ninthgiant/Burrow_Scale_Monitor/README.md

# Burrow_Scale_Monitor
Supplemental Information for Mauck, et al. 2025. Final versions of Arduino, Python, and 3D printing files for the Burrow Scale Monitoring system.
