ninthgiant/Burrow_Scale_Monitor/3D printing/ConnectorAssembly_WireClamp.3mf

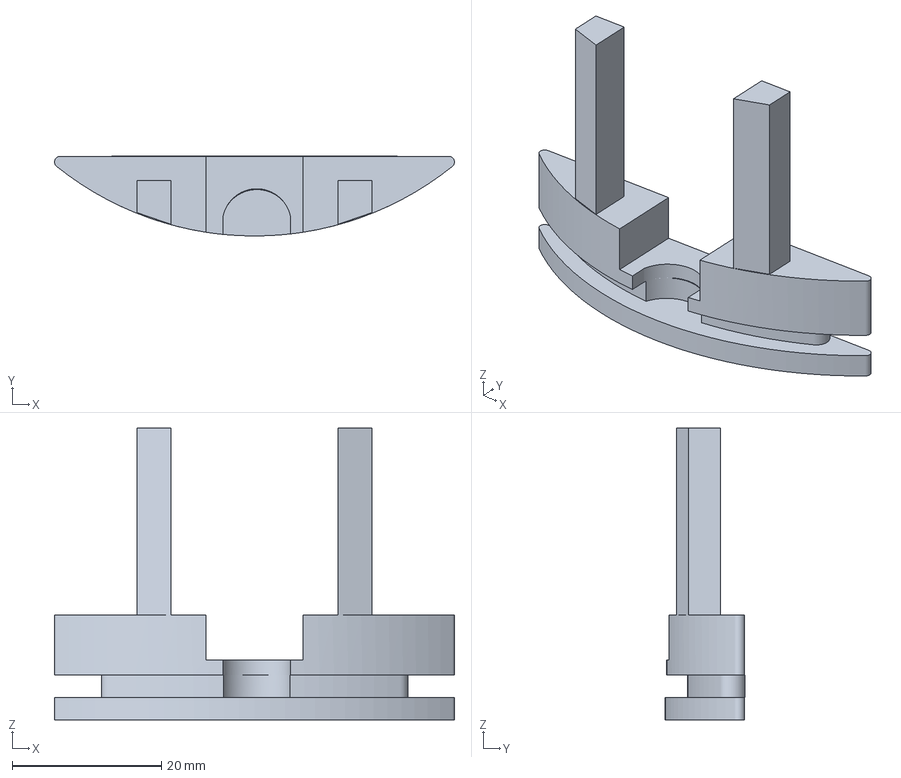
[picture p1: CAD file, 2025-09-29]
3D printing/ConnectorAssembly_WireClamp.3mf
53.5 x 10.7 x 39.0 mm
