ninthgiant/Burrow_Scale_Monitor/3D printing/ConnectorAssembly_Plug.3mf

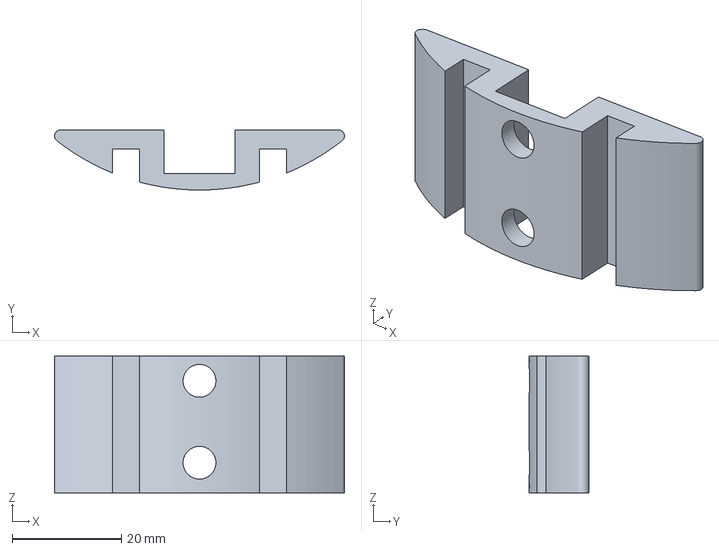
[picture p2: CAD file, 2025-09-29]
3D printing/ConnectorAssembly_Plug.3mf
53.1 x 11.0 x 25.0 mm
