ninthgiant/Burrow_Scale_Monitor/3D printing/Weight_Platform.3mf

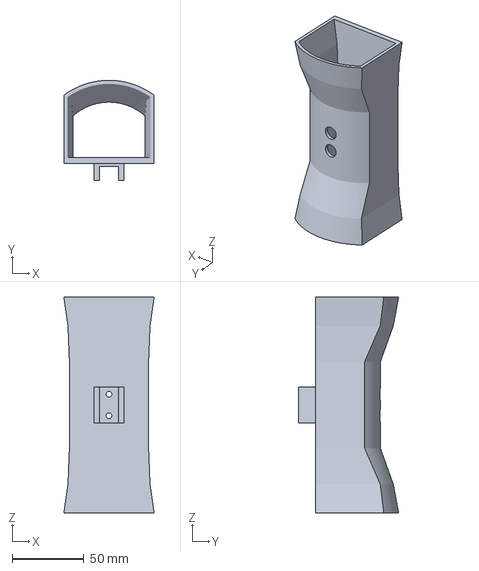
[picture p3: CAD file, 2025-09-29]
3D printing/Weight_Platform.3mf
62.7 x 69.7 x 150.0 mm
