ninthgiant/Burrow_Scale_Monitor/3D printing/SuperJig_001.3mf

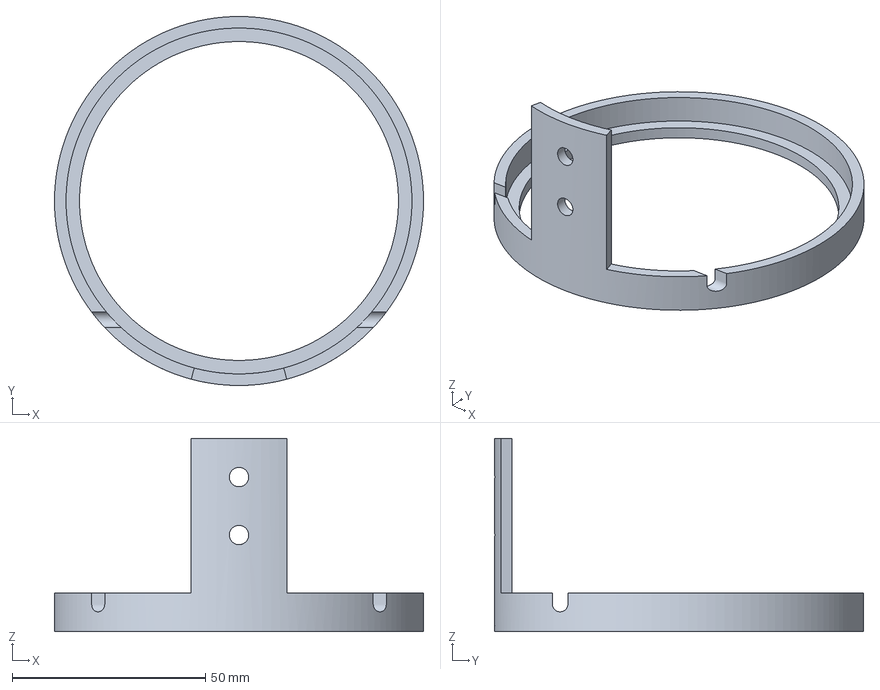
[picture p4: CAD file, 2025-09-29]
3D printing/SuperJig_001.3mf
95.6 x 95.6 x 50.0 mm
