ninthgiant/Burrow_Scale_Monitor/3D printing/Exit_Cap.3mf

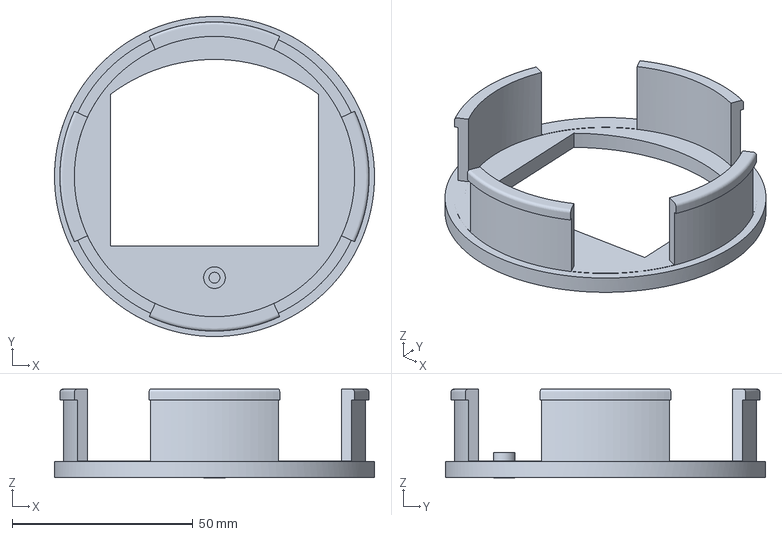
[picture p5: CAD file, 2025-09-29]
3D printing/Exit_Cap.3mf
88.6 x 88.6 x 24.6 mm
