ninthgiant/Burrow_Scale_Monitor/3D printing/Entrance_Cap.3mf

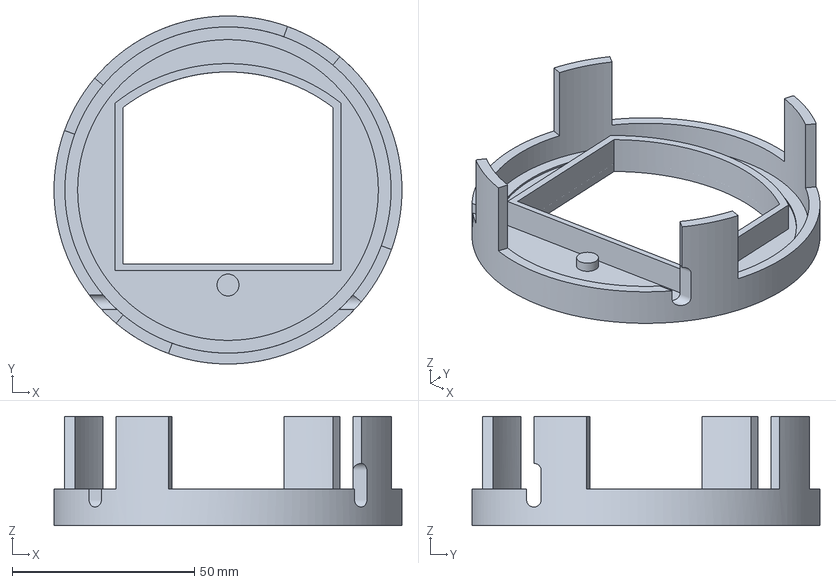
[picture p6: CAD file, 2025-09-29]
3D printing/Entrance_Cap.3mf
95.6 x 95.6 x 30.0 mm
