ninthgiant/Burrow_Scale_Monitor/Arduino Code/BSM_Fritzing.pdf

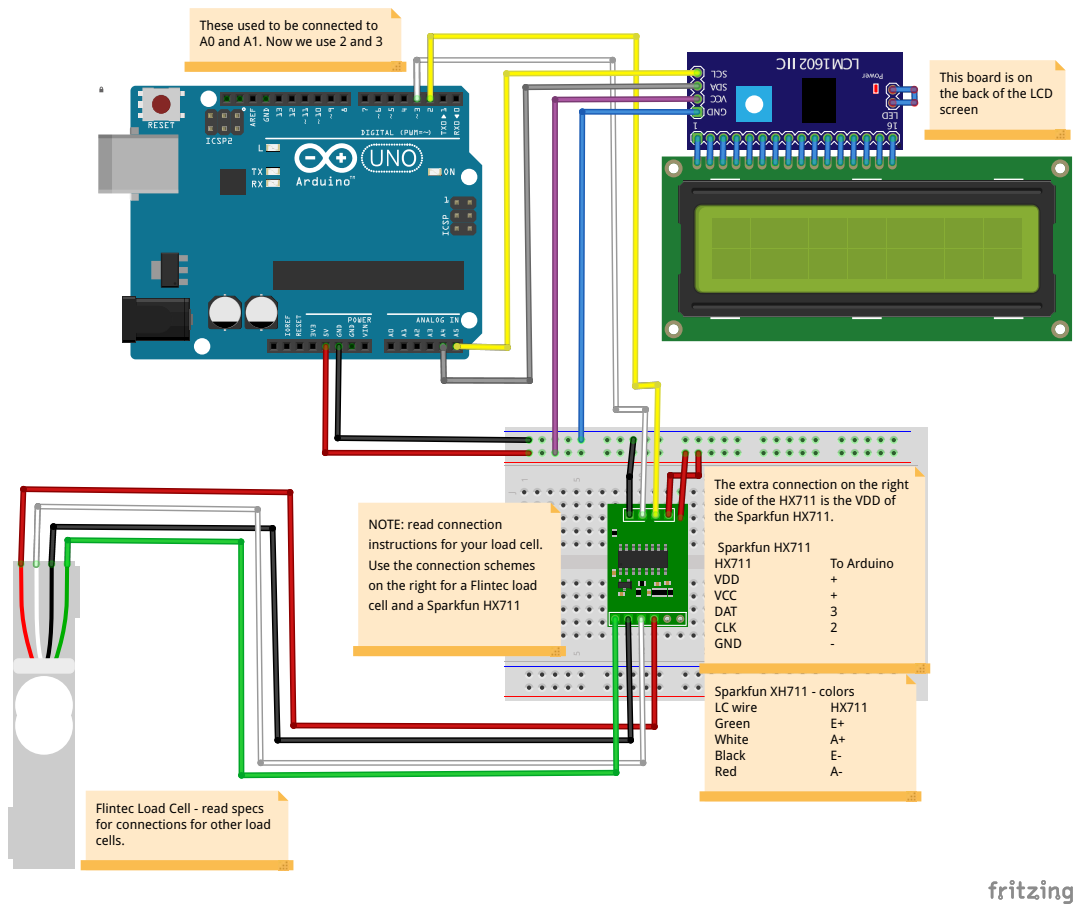
[picture p7: page 1]
Sparkfun XH711 - colors; LC wire; Green; White; Black; Red; Sparkfun HX711; To Arduino; VDD; VCC; DAT; CLK; GND

These used to be connected to
A0 and A1. Now we use 2 and 3

This board is on
the back of the LCD
screen

The extra connection on the right
side of the HX711 is the VDD of
the Sparkfun HX711.

NOTE: read connection
instructions for your load cell.
Use the connection schemes
on the right for a Flintec load
cell and a Sparkfun HX711

Flintec Load Cell - read specs
for connections for other load
cells.
