ninthgiant/Burrow_Scale_Monitor/Arduino Code/PRDC_AD7193/src/PRDC_AD7193.cpp

/**
 * PRDC_AD7193.cpp - Analog Devices AD7193 ADC Library
 * Author: Milos Petrasinovic <mpetrasinovic@pr-dc.com>
 * PR-DC, Republic of Serbia
 * info@pr-dc.com
 * 
 * --------------------
 * Copyright (C) 2021 PR-DC <info@pr-dc.com>
 *
 * This file is part of PRDC_AD7193.
 *
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
 */

#include "PRDC_AD7193.h"

// PRDC_AD7193()
// Object constructor
// --------------------
PRDC_AD7193::PRDC_AD7193() :
  _spiSettings(AD7193_DEFAULT_SPI_FREQUENCY, MSBFIRST, SPI_MODE3),
  _spi(&AD7193_DEFAULT_SPI), _CS(AD7193_DEFAULT_CS), _MISO(AD7193_DEFAULT_MISO) {
  //_spi(&AD7193_DEFAULT_SPI), _CS(PIN_SPI_SS), _MISO(PIN_SPI_MISO) {

}

// setSPI() function
// Set SPI object
// --------------------
void PRDC_AD7193::setSPI(SPIClass& spi) {
  #ifdef DEBUG_AD7193
    Serial.println(F("setSPI()"));
  #endif
  
  _spi = &spi;
}

// setSPIFrequency() function
// Set SPI frequency
// --------------------
void PRDC_AD7193::setSPIFrequency(uint32_t frequency) {
  #ifdef DEBUG_AD7193
    Serial.println(F("setSPIFrequency()"));
  #endif
  
  _spiSettings = SPISettings(frequency, MSBFIRST, SPI_MODE3);
}

// beginTransaction() function
// Begin SPI transaction 
// --------------------
inline void PRDC_AD7193::beginTransaction() {
  _spi->beginTransaction(_spiSettings);
  digitalWrite(_CS, LOW);
}

// endTransaction() function
// End SPI transaction 
// --------------------
inline void PRDC_AD7193::endTransaction() {
  digitalWrite(_CS, HIGH);
  _spi->endTransaction();
}

// getRegister() function
// Reads the value of a register
// --------------------
uint32_t PRDC_AD7193::getRegister(uint8_t registerAddress, uint8_t bytesNumber) {
  #ifdef DEBUG_AD7193
    Serial.println(F("getRegister()"));
    Serial.print(F("Register "));
    Serial.println(registerAddress);
  #endif
  
  uint32_t buffer = 0x0;
  _spi->transfer(AD7193_COMM_READ | AD7193_COMM_ADDR(registerAddress));
  for(uint8_t i = 0; i < bytesNumber; i++)  {
      buffer = (buffer << 8) + _spi->transfer(0);
  }
  
  #ifdef DEBUG_AD7193
    Serial.println(buffer);
  #endif
  return buffer; 
}

// getSingleRegister() function
// Reads the value of a single register
// --------------------
uint32_t PRDC_AD7193::getSingleRegister(uint8_t registerAddress, uint8_t bytesNumber) {
  #ifdef DEBUG_AD7193
    Serial.println(F("getSingleRegister()"));
  #endif
  
  this->beginTransaction();
  uint32_t regVal = this->getRegister(registerAddress, bytesNumber);
  this->endTransaction();
  return regVal;
}

// setRegister() function
// Set the value of a register
// --------------------
void PRDC_AD7193::setRegister(uint8_t registerAddress, uint32_t value, uint8_t bytesNumber) {
  #ifdef DEBUG_AD7193
    Serial.println(F("setRegister()"));
    Serial.print(F("Register "));
    Serial.print(registerAddress);
    Serial.print(F(" Value "));
    Serial.println(value);
  #endif
  
  uint8_t* dataPointer = (uint8_t*)&value;
  _spi->transfer(AD7193_COMM_WRITE | AD7193_COMM_ADDR(registerAddress));
  for(uint8_t i = 0; i < bytesNumber; i++)  {
    _spi->transfer(*(dataPointer + (bytesNumber-1) - i));
  }
}

// setSingleRegister() function
// Set the value of a single register
// --------------------
void PRDC_AD7193::setSingleRegister(uint8_t registerAddress, uint32_t value, uint8_t bytesNumber) {
  #ifdef DEBUG_AD7193
    Serial.println(F("setSingleRegister()"));
  #endif
  
  this->beginTransaction();
  this->setRegister(registerAddress, value, bytesNumber);
  this->endTransaction();
}

// begin() function
// Begin communication
// --------------------
bool PRDC_AD7193::begin() {
  #ifdef DEBUG_AD7193
    Serial.println(F("begin()"));
    Serial.println(F("PRDC_AD7193 constructor instantiated successfully"));
    Serial.print(F("CS "));
    Serial.println(_CS);
    Serial.print(F("MISO "));
    Serial.println(_MISO);
  #endif
  
  _spi->begin();
  this->pinInit();
  this->reset();
  if(this->checkID()) {
    return true;
  }
  return false;
}

bool PRDC_AD7193::begin(uint8_t CS, uint8_t MISO) {
  _CS = CS;
  _MISO = MISO;
  return this->begin();
}

// end() function
// End communication
// --------------------
void PRDC_AD7193::end() {
  #ifdef DEBUG_AD7193
    Serial.println(F("end()"));
  #endif
  
  _spi->end();
}

// pinInit() function
// Pin initialization
// --------------------
void PRDC_AD7193::pinInit() {
  #ifdef DEBUG_AD7193
    Serial.println(F("pinInit()"));
  #endif

  pinMode(_CS, OUTPUT);
  digitalWrite(_CS, HIGH);
}

// reset() function
// Reset ADC
// --------------------
void PRDC_AD7193::reset() {
  #ifdef DEBUG_AD7193
    Serial.println(F("reset()"));
  #endif

  this->beginTransaction();
  _spi->transfer(0xFF);
  _spi->transfer(0xFF);
  _spi->transfer(0xFF);
  _spi->transfer(0xFF);
  _spi->transfer(0xFF);
  _spi->transfer(0xFF);
  this->endTransaction();
}

// setClockMode() function
// Set clock mode (internal or external)
// --------------------
void PRDC_AD7193::setClockMode(uint8_t clock_mode) {
  #ifdef DEBUG_AD7193
    Serial.println(F("setClockMode()"));
  #endif
  
  _clock_mode = clock_mode;
}

// setRate() function
// Set output data rate
// --------------------
void PRDC_AD7193::setRate(uint32_t rate) {
  #ifdef DEBUG_AD7193
    Serial.println(F("setRate()"));
  #endif
  
  _rate = rate;
}

// setFilter() function
// Set filter type (Sinc3 or Sinc4)
// --------------------
void PRDC_AD7193::setFilter(uint32_t filter) {
  #ifdef DEBUG_AD7193
    Serial.println(F("setFilter()"));
  #endif
  
  _filter = filter;
  
  updateConf();
}

// enableNotchFilter() function
// Turn on or off notch filter;
// --------------------
void PRDC_AD7193::enableNotchFilter(bool notch_state) {
  #ifdef DEBUG_AD7193
    Serial.println(F("enableNotchFilter()"));
  #endif
  
  if(notch_state) {
    _notch_filter = AD7193_MODE_REJ60;
  } else {
    _notch_filter = AD7193_MODE_NO_REJ60;
  }
  
  updateConf();
}

// enableChop() function
// Turn on or off chop;
// --------------------
void PRDC_AD7193::enableChop(bool chop_state) {
  #ifdef DEBUG_AD7193
    Serial.println(F("enableChop()"));
  #endif
  
  if(chop_state) {
    _chop = AD7193_CONF_CHOP;
  } else {
    _chop = AD7193_CONF_NO_CHOP;
  }
  
  updateConf();
}

// enableBuffer() function
// Turn on or off buffer;
// --------------------
void PRDC_AD7193::enableBuffer(bool buffer_state) {
  #ifdef DEBUG_AD7193
    Serial.println(F("enableBuffer()"));
  #endif
  
  if(buffer_state) {
    _buf = AD7193_CONF_BUF;
  } else {
    _buf = AD7193_CONF_NO_BUF;
  }
  
  updateConf();
}

// updateConf() function
// Update conf register
// --------------------
void PRDC_AD7193::updateConf(void) {
  #ifdef DEBUG_AD7193
    Serial.println(F("updateConf()"));
  #endif
  
  uint32_t command = AD7193_CONF_CHAN(1 << _channel) | 
                    (_polarity * AD7193_CONF_UNIPOLAR) |
                    _gain |
                    _filter |
                    _notch_filter | 
                    _chop |
                    _buf |
                    _burnout; 
                        
  this->beginTransaction();
  this->setRegister(AD7193_REG_CONF, command, 3);
  this->endTransaction();
}

// checkID() function
// Check ADC ID register
// --------------------
bool PRDC_AD7193::checkID() {
  #ifdef DEBUG_AD7193
    Serial.println(F("checkID()"));
  #endif
  
  uint8_t regVal = getSingleRegister(AD7193_REG_ID, 1);
  #ifdef DEBUG_AD7193
    Serial.print(F("ID = "));
    Serial.println(regVal & AD7193_ID_MASK);
  #endif
  return (regVal & AD7193_ID_MASK) == ID_AD7193;
}

// waitReady() function
// Waits for MISO pin to go low
// --------------------
void PRDC_AD7193::waitReady() {
  #ifdef DEBUG_AD7193
    Serial.println(F("waitReady()"));
  #endif
  while(digitalRead(_MISO)) {}
}

// setPower() function
// Set device to idle or power-down
// mode = 
//  0 - power-down
//  1 - idle
// --------------------
void PRDC_AD7193::setPower(uint8_t mode) {
  #ifdef DEBUG_AD7193
    Serial.println(F("setPower()"));
  #endif
  
   uint32_t oldPwrMode = this->getSingleRegister(AD7193_REG_MODE, 3);
   oldPwrMode &= ~(AD7193_MODE_SEL(0x7));
   uint32_t newPwrMode = oldPwrMode | 
                         AD7193_MODE_SEL((mode * (AD7193_MODE_IDLE)) |
                         (!mode * (AD7193_MODE_PWRDN)));
   this->setSingleRegister(AD7193_REG_MODE, newPwrMode, 3); 
}

// channelSelect() function
// Selects the channel to be enabled
// --------------------
void PRDC_AD7193::channelSelect(uint8_t channel) {
  #ifdef DEBUG_AD7193
    Serial.println(F("channelSelect()"));
  #endif
  
  _channel = channel;

  updateConf();
}

// calibrate() function
// Performs the given calibration to the specified channel
// --------------------
void PRDC_AD7193::calibrate(uint8_t mode, uint8_t channel) {  
  #ifdef DEBUG_AD7193
    Serial.println(F("calibrate()"));
  #endif
  
  this->channelSelect(channel);
  uint32_t oldRegValue = this->getSingleRegister(AD7193_REG_MODE, 3);
  oldRegValue &= ~AD7193_MODE_SEL(0x7);
  uint32_t newRegValue = oldRegValue | AD7193_MODE_SEL(mode);
  this->beginTransaction();
  this->setRegister(AD7193_REG_MODE, newRegValue, 3);
  this->waitReady();
  this->endTransaction();
}

// rangeSetup() function
// Selects the polarity of the conversion and the ADC input range
// --------------------
void PRDC_AD7193::rangeSetup(uint8_t polarity, uint8_t range) {
  #ifdef DEBUG_AD7193
    Serial.println(F("rangeSetup()"));
  #endif
  
  _polarity = polarity;
  _gain = AD7193_CONF_GAIN(range);
  updateConf();
}

// singleConversion() function
// Returns the result of a single conversion
// --------------------
uint32_t PRDC_AD7193::singleConversion() {
  #ifdef DEBUG_AD7193
    Serial.println(F("singleConversion()"));
  #endif
  
  uint32_t command = AD7193_MODE_SEL(AD7193_MODE_SINGLE) | 
                     AD7193_MODE_CLKSRC(_clock_mode) |
                     AD7193_MODE_RATE(_rate); 
  this->beginTransaction();
  this->setRegister(AD7193_REG_MODE, command, 3);
  this->waitReady();
  uint32_t raw = this->getRegister(AD7193_REG_DATA, 3);
  this->endTransaction();
  
  return raw;
}

// continuousReadAverage() function
// Returns the average of several conversion results
// --------------------
uint32_t PRDC_AD7193::continuousReadAverage(uint32_t sampleNumber) {
  #ifdef DEBUG_AD7193
    Serial.println(F("continuousReadAverage()"));
  #endif
  
  uint32_t samplesAverage = 0;  
  uint32_t command = AD7193_MODE_SEL(AD7193_MODE_CONT) | 
                     AD7193_MODE_CLKSRC(_clock_mode) |
                     AD7193_MODE_RATE(_rate);
            
  this->beginTransaction();
  this->setRegister(AD7193_REG_MODE, command, 3);
  for(uint32_t i = 0; i < sampleNumber; i++) {
    this->waitReady();
    samplesAverage += this->getRegister(AD7193_REG_DATA, 3);
  }
  this->endTransaction();
  
  return samplesAverage/sampleNumber;
}

// continuousRead() function
// Executes continuous read command and puts readings in a buffer
// --------------------
void PRDC_AD7193::continuousRead(uint32_t sampleNumber, uint32_t *buffer) {
  #ifdef DEBUG_AD7193
    Serial.println(F("readAverage()"));
  #endif
   
  uint32_t command = AD7193_MODE_SEL(AD7193_MODE_CONT) | 
                     AD7193_MODE_CLKSRC(_clock_mode) |
                     AD7193_MODE_RATE(_rate);
            
  this->beginTransaction();
  this->setRegister(AD7193_REG_MODE, command, 3);
  for(uint32_t i = 0; i < sampleNumber; i++) {
    this->waitReady();
    buffer[i] = this->getRegister(AD7193_REG_DATA, 3);
  }
  this->endTransaction();
}

// temperatureRead() function
// Read data from temperature sensor and converts it to Celsius degrees
// --------------------
float PRDC_AD7193::temperatureRead() {
  #ifdef DEBUG_AD7193
    Serial.println(F("temperatureRead()"));
  #endif
  
  this->rangeSetup(0, AD7193_CONF_GAIN_1); // Bipolar operation, 0 Gain.
  this->channelSelect(AD7193_CH_TEMP);
  uint32_t dataReg = this->singleConversion();
  dataReg -= 0x800000;
  return (float)dataReg/2815.0-273; // Celsius Temperature
}

// rawToVolts() function
// Converts 24-bit raw data to volts
// --------------------
float PRDC_AD7193::rawToVolts(uint32_t raw, float vRef) {
  #ifdef DEBUG_AD7193
    Serial.println(F("rawToVolts()"));
  #endif
  
  float voltage;
  if(_polarity == 0) {
    // Bipolar mode
    voltage = (((float)raw/(1ul << 23))-1)*vRef/_gain;
  } else {
    // Unipolar mode
    voltage = ((float)raw*vRef)/(1ul << 24)/_gain;
  }
  
  return voltage;
}

// printAllRegisters() function
// Print value of each register
// --------------------
void PRDC_AD7193::printAllRegisters(void)  {
  Serial.println(F("Read all registers"));
  this->beginTransaction();
  Serial.println(F("Register 0"));
  Serial.println(this->getRegister(0, 1));
  Serial.println(F("Register 1"));
  Serial.println(this->getRegister(1, 3));
  Serial.println(F("Register 2"));
  Serial.println(this->getRegister(2, 3));
  Serial.println(F("Register 3"));
  Serial.println(this->getRegister(3, 3));
  Serial.println(F("Register 4"));
  Serial.println(this->getRegister(4, 1));
  Serial.println(F("Register 5"));
  Serial.println(this->getRegister(5, 1));
  Serial.println(F("Register 6"));
  Serial.println(this->getRegister(6, 3));
  Serial.println(F("Register 7"));
  Serial.println(this->getRegister(7, 3));
  this->endTransaction();
}
