ninthgiant/Burrow_Scale_Monitor/(commit log)

2025-09-29 Create .gitkeep
    Arduino IDE files for controlling the Burrow Scale Monitor.
2025-09-29 Create .gitkeep
    Files to print the components of the tunnel, etc., for the BSM.
2025-09-29 Create .gitkeep
    Files to print the physical components of the BSM
2025-09-29 Directory for Arduino construction and coding
2025-09-29 Definition of PRDC_AD7193 for use with Arduino R4
2025-09-29 Files in 3MF format to print physical structures.
    [ConnectorAssembly_Plug.3mf, ConnectorAssembly_WireClamp.3mf, Entrance_Cap.3mf, Exit_Cap.3mf, SuperJig_001.3mf, Weight_Platform.3mf]
2025-09-29 Dataset for BSM analysis of field data
    With 241 BSM measurements, 240 of which have known chick age.
    [BSM_Full_dataset.csv]
