ninthgiant/Burrow_Scale_Monitor/(notices)

Notices in the files:
Arduino Code/PRDC_AD7193/src/PRDC_AD7193.h:
PRDC_AD7193 is free software: you can redistribute it and/or modify
it under the terms of the GNU Lesser General Public License as
published by the Free Software Foundation, either version 3 of the
License, or (at your option) any later version.
